roverics/tracked-platform/prototypes/p0/photos/README.md

# P0 Photos and Video

Add only curated evidence that supports a design or test record. Prefer descriptive filenames such as `2026-10-15_single-track-test_setup.jpg`, and link each file from its record with a caption explaining what it demonstrates.

Before committing, remove unnecessary EXIF location/device metadata and check frames for credentials, faces, addresses, customer material, and unrelated workshop information. Large media uses Git LFS; avoid raw dumps and duplicates.
