roverics/tracked-platform/prototypes/p0/electronics/firmware/README.md

# P0 Firmware

Store reproducible firmware and control sources here when available. Each project should document its target board, toolchain and version, locked dependencies, build and flash commands, configuration method, communications protocol, and safe default behavior.

Secrets and machine-specific configuration stay outside Git. Test records should cite the exact Git commit used.
