roverics/tracked-platform/prototypes/p0/electronics/docs/images/README.md

# Project Image Plan

No photographs are included yet. Add only photographs of the real hardware and keep captions factual. Useful filenames are:

| Filename | Suggested content |
|---|---|
| `01_initial_motor_test.jpg` | Uno, BTS7960, motor, and external supply used for the initial bench test |
| `02_nrf_bench_test.jpg` | Standard NRF24L01 radio-only bench setup |
| `03_controller_prototype.jpg` | Nano, joystick, and standard NRF24L01 controller prototype |
| `04_mega_bts7960_setup.jpg` | Mega receiver and BTS7960 rover-side setup |
| `05_encoder_setup.jpg` | Optical sensor and 20-slot encoder disk, including alignment |
| `06_tracked_chassis.jpg` | Current approximately 25 × 25 cm tracked chassis |
| `07_controller_mockup.jpg` | Temporary controller test bench or panel mock-up |
| `08_rover_electronics_mockup.jpg` | Temporary rover-side electronics test bench |

When adding an image, record the date, visible hardware, test context, and whether the setup produced a verified, partial, attempted, acquired-only, or planned result. Do not use concept renders as evidence of constructed hardware.
