roverics/tracked-platform/docs/r1-requirements.md

# R1 Requirements and Planning

Status: **planning only**. R1 is a future full-size, production-intent tracked platform. It has not been represented here as fabricated, tested, manufactured, or load-rated.

P0 results are inputs to R1 requirements; they are not automatically scalable proof. In particular, no validated 100 kg capacity is currently documented.

## Requirement method

Each requirement should eventually include an ID, measurable statement, rationale/source, verification method, owner, and status. Use `TBD` instead of guessing.

| ID | Topic | Requirement | Rationale/source | Verification | Status |
| --- | --- | --- | --- | --- | --- |
| R1-SYS-001 | Intended use | TBD after use cases and operating environment are agreed | Product planning | Review | Open |
| R1-MEC-001 | Payload/load definition | TBD; distinguish payload, gross mass, static load, and dynamic load cases | Safety and structure | Analysis plus instrumented test | Open |
| R1-MOB-001 | Mobility envelope | TBD surface, grade, obstacle, speed, and turning requirements | Use cases | Instrumented test | Open |
| R1-PWR-001 | Energy/runtime | TBD duty cycle, runtime, charging, and storage constraints | Use cases and safety | Analysis plus test | Open |
| R1-SAF-001 | Safe stop | TBD stopping, isolation, fault response, and emergency-stop behavior | Risk assessment | Inspection plus test | Open |
| R1-ENV-001 | Environment | TBD temperature, water/dust, corrosion, and storage ranges | Operating context | Analysis plus test | Open |
| R1-SVC-001 | Serviceability | TBD access, replaceable modules, tools, and maintenance intervals | Lifecycle planning | Demonstration | Open |

## Inputs needed before baselining

- prioritized customer/use cases;
- terrain and environmental definitions;
- payload versus vehicle mass terminology and targets;
- legal, transport, and safety constraints for intended markets;
- manufacturing volume and cost assumptions;
- P0 drivetrain, track, thermal, power, and control evidence; and
- subsystem interface definitions with measurable acceptance criteria.

A requirement is not “validated” until its stated verification is completed against an identified R1 configuration.
