roverics/tracked-platform/docs/evidence-media-review-2026-10-04.md

# Evidence media review — 4 October 2026

This date is the review date, not an inferred capture or fabrication date. Original files remain in their supplied folders.

| Source under `prototypes/p0/` | Evidence supported | Boundary |
| --- | --- | --- |
| `mechanical/exports/Artifact-01-Half-LAne-Chassis.jpg` | Physical partial lane assembly: printed structure, shafts, bearings, toothed wheels and belt drive visible | No powered operation, complete track circulation, calibrated dimensions or load result |
| `mechanical/exports/Boggie System.jpg` | CAD render of wheels, linkage and suspension layout | Does not establish fabricated suspension |
| `mechanical/exports/Roverics P0 Assembly.jpg` | Full-vehicle CAD arrangement | Does not establish assembled or driving whole vehicle |
| `electronics/export/Embedded.jpg` | Wired bench electronics, radio hardware, display module and illuminated indicators | No performance, safety or complete integration result |
| `electronics/export/LCD.jpg` | Screen visibly displays ROVER, 14.3V and a bar graphic | Value source and calibration unknown; do not equate this with validated live telemetry. Visible August 20 timestamp has no year |

Five mechanical STL exports are displayed through an on-demand Three.js viewer on the website: lane chassis, exposed drivetrain, bogie, middle chassis roof and RC shock absorber. Rotation, pan, zoom and wireframe are inspection aids. Source units and part revisions remain unspecified; the viewer normalizes geometry for display and provides no dimensional measurement claim.

The photos support partial physical assembly and visible display output beyond the earlier CAD/acquisition summaries. They do not supersede the historical single-motor and encoder test records, or establish powered-track operation. Requested follow-up: capture dates, part/configuration revisions, display firmware and signal source, and videos/raw data for powered tests.
