roverics/tracked-platform/(list of files, cad)

Other CAD files:
prototypes/p0/mechanical/exports/Lane Chassis Assembly.stl
prototypes/p0/mechanical/exports/Middle Chassis Roof Assembly.stl
prototypes/p0/mechanical/exports/Nked ane Chassis Assembly to Show Sp Rocket.stl
prototypes/p0/mechanical/exports/Roverics P0 Assembly.stl
prototypes/p0/mechanical/cad/Parts/gt2-40-teeth-bore-8mm-belt-6mm-1.snapshot.2/GT2_40T_8_6.STEP
prototypes/p0/mechanical/cad/Parts/gt2-timing-pulley-t40-1.snapshot.1/GT2 Timing Pulley T40.stp
prototypes/p0/mechanical/cad/Parts/timing-pulley-gt2-20t-8mm-bore-1.snapshot.8/GT2_20T-sh8.STEP
prototypes/p0/mechanical/cad/Sp Rocket Gear/Sp Rocket.dwg
prototypes/p0/mechanical/exports/Boggie System.stl
prototypes/p0/mechanical/exports/RC Shock Absorber.stl
prototypes/p0/mechanical/cad/Cabin/BTS7960 43A HIGH POWER H BRIDGE MODULE/BTS7960 43A HIGH POWER H BRIDGE MODULE.ipt
prototypes/p0/mechanical/cad/Cabin/Battery Pack.ipt
prototypes/p0/mechanical/cad/Cabin/Cabin 2nd Floor.ipt
prototypes/p0/mechanical/cad/Cabin/Cabin Assembly.iam
prototypes/p0/mechanical/cad/Cabin/Cabin Chassis Part 1.ipt
prototypes/p0/mechanical/cad/Cabin/Cabin Chassis Part 2.ipt
prototypes/p0/mechanical/cad/Cabin/CabinParameters.ipt
prototypes/p0/mechanical/cad/Cabin/Cover310-v2.ipt
prototypes/p0/mechanical/cad/Cabin/Motor/5840-31ZY D8.ipt
prototypes/p0/mechanical/cad/Full Assembly/Roverics P0 Assembly.iam
prototypes/p0/mechanical/cad/Lane Chassis/Boggie System/Boggie System.iam
prototypes/p0/mechanical/cad/Lane Chassis/Boggie System/Link_Gear_to_middle.ipt
prototypes/p0/mechanical/cad/Lane Chassis/Boggie System/Moddle Wheels Link.ipt
prototypes/p0/mechanical/cad/Lane Chassis/Custom RC Shock Absorber/Bigger Version/Rods.ipt
prototypes/p0/mechanical/cad/Lane Chassis/Custom RC Shock Absorber/Body.ipt
prototypes/p0/mechanical/cad/Lane Chassis/Custom RC Shock Absorber/Bot Cap.ipt
prototypes/p0/mechanical/cad/Lane Chassis/Custom RC Shock Absorber/RC Shock Absorber.iam
prototypes/p0/mechanical/cad/Lane Chassis/Custom RC Shock Absorber/Shaft.ipt
prototypes/p0/mechanical/cad/Lane Chassis/Custom RC Shock Absorber/Top Cap thread.ipt
prototypes/p0/mechanical/cad/Lane Chassis/Custom RC Shock Absorber/Top Cap-NO-THREAD.ipt
prototypes/p0/mechanical/cad/Lane Chassis/Custom RC Shock Absorber/Top Cap.ipt
prototypes/p0/mechanical/cad/Lane Chassis/Custom RC Shock Absorber/ring.ipt
prototypes/p0/mechanical/cad/Lane Chassis/EndWheelShaft.ipt
prototypes/p0/mechanical/cad/Lane Chassis/Idler Support.ipt
prototypes/p0/mechanical/cad/Lane Chassis/Lane Chassis Assembly.iam
prototypes/p0/mechanical/cad/Lane Chassis/Middle Chassis Assembly.iam
prototypes/p0/mechanical/cad/Lane Chassis/Middle Chassis Roof Assembly.iam
prototypes/p0/mechanical/cad/Lane Chassis/Middle Chassis-Left Cover - Begin.ipt
prototypes/p0/mechanical/cad/Lane Chassis/Middle Chassis-Left Cover - End.ipt
prototypes/p0/mechanical/cad/Lane Chassis/Middle Chassis-Right Cover - Begin.ipt
prototypes/p0/mechanical/cad/Lane Chassis/Middle Chassis-Right Cover - End.ipt
prototypes/p0/mechanical/cad/Lane Chassis/Middle Chassis-Roof.ipt
prototypes/p0/mechanical/cad/Lane Chassis/Roof Connector.ipt
prototypes/p0/mechanical/cad/Lane Chassis/TopWheelHolder.ipt
prototypes/p0/mechanical/cad/Lane Chassis/Wheels/Boggie-ParametricWheel.ipt
prototypes/p0/mechanical/cad/Lane Chassis/Wheels/DoubleWheel-part1.ipt
prototypes/p0/mechanical/cad/Lane Chassis/Wheels/DoubleWheel.iam
prototypes/p0/mechanical/cad/Lane Chassis/Wheels/End Wheel = Part 1.ipt
prototypes/p0/mechanical/cad/Lane Chassis/Wheels/End Wheel.iam
prototypes/p0/mechanical/cad/Lane Chassis/Wheels/EndWheelShaft.ipt
prototypes/p0/mechanical/cad/Lane Chassis/Wheels/MiddleWheelShaft.ipt
prototypes/p0/mechanical/cad/Lane Chassis/Wheels/ParametricWheel.ipt
prototypes/p0/mechanical/cad/Lane Chassis/Wheels/TopRoller-Begin-ParametricWheel.ipt
prototypes/p0/mechanical/cad/Lane Chassis/Wheels/TopRoller-End-ParametricWheel.ipt
prototypes/p0/mechanical/cad/Lane Chassis/Wheels/TopRoller-Mid-ParametricWheel.ipt
prototypes/p0/mechanical/cad/Lane Chassis/Wheels/TopRoller-Middle ParametricWheel.ipt
prototypes/p0/mechanical/cad/Lane Chassis/Wheels/TopRollerAssmbly-Begin.iam
prototypes/p0/mechanical/cad/Lane Chassis/Wheels/TopRollerAssmbly-End.iam
prototypes/p0/mechanical/cad/Lane Chassis/Wheels/TopRollerAssmbly-Middle.iam
prototypes/p0/mechanical/cad/Lane Chassis/Wheels/TopRollerShaft-Begin.ipt
prototypes/p0/mechanical/cad/Lane Chassis/Wheels/WHHEL LINK CONNECTOR.ipt
prototypes/p0/mechanical/cad/Lane Chassis/Wheels/Wheel 20.ipt
prototypes/p0/mechanical/cad/Lane Chassis/Wheels/Wheel 25.ipt
prototypes/p0/mechanical/cad/Lane Chassis/Wheels/Wheel 30.ipt
prototypes/p0/mechanical/cad/Lane Chassis/Wheels/Wheel 30_MIR.ipt
prototypes/p0/mechanical/cad/Lane Chassis/Wheels/Wheel 40.ipt
prototypes/p0/mechanical/cad/Lane Chassis/Wheels/Wheel Link Column.ipt
prototypes/p0/mechanical/cad/Lane Chassis/Wheels/Wheels Link.ipt
prototypes/p0/mechanical/cad/Lane Chassis/Wheels/Whhel 20 Assembly.iam
prototypes/p0/mechanical/cad/Lane Chassis/Wheels/Whhel 30 Assembly.iam
prototypes/p0/mechanical/cad/Lane Chassis/Wheels/Whhel 30 Assembly_MIR5.iam
prototypes/p0/mechanical/cad/Lane Chassis/Wheels/Whhel 40 Assembly.iam
prototypes/p0/mechanical/cad/MasterParameters.ipt
prototypes/p0/mechanical/cad/Motor Shaft/Faield Tests/RollerChainSprocket_8T_6.35mm-Sprocket/RollerChainSprocket_8T_6.35mm-Sprocket/RollerChainSprocket_8T_6.35mm-Sprocket.ipt
prototypes/p0/mechanical/cad/Motor Shaft/Faield Tests/Shaft for Chain System/Assembly1.iam
prototypes/p0/mechanical/cad/Motor Shaft/Faield Tests/Shaft for Chain System/Gear.ipt
prototypes/p0/mechanical/cad/Motor Shaft/Faield Tests/Shaft for Chain System/Motor Shaft Assembly.iam
prototypes/p0/mechanical/cad/Motor Shaft/Faield Tests/Shaft for Chain System/Motor Shaft.ipt
prototypes/p0/mechanical/cad/Motor Shaft/Faield Tests/Shaft for Chain System/Part7.ipt
prototypes/p0/mechanical/cad/Motor Shaft/Faield Tests/Shaft for Chain System/Shaft Chain.ipt
prototypes/p0/mechanical/cad/Motor Shaft/Faield Tests/Shaft for Chain System/Shaft Mold.ipt
prototypes/p0/mechanical/cad/Motor Shaft/Faield Tests/Shaft for Chain System/Small Gear.ipt
prototypes/p0/mechanical/cad/Motor Shaft/Faield Tests/Shaft for Chain System/large gear.ipt
prototypes/p0/mechanical/cad/Motor Shaft/Faield Tests/gear test.ipt
prototypes/p0/mechanical/cad/Motor Shaft/Faield Tests/test/16teeth gear/16teeth gear/16teeth gear.ipt
prototypes/p0/mechanical/cad/Motor Shaft/Faield Tests/test/shaft-test.ipt
prototypes/p0/mechanical/cad/Motor Shaft/Faield Tests/test/test shaft assmebly.iam
prototypes/p0/mechanical/cad/Motor Shaft/Shaft Part1.ipt
prototypes/p0/mechanical/cad/Motor Shaft/Shaft Part2.ipt
prototypes/p0/mechanical/cad/Motor Shaft/Shaft.ipt
prototypes/p0/mechanical/cad/Optocounter/Disk.ipt
prototypes/p0/mechanical/cad/Parts/2.3X12mm rod.ipt
prototypes/p0/mechanical/cad/Parts/2mm rod.ipt
prototypes/p0/mechanical/cad/Parts/Coupling-25X8.ipt
prototypes/p0/mechanical/cad/Parts/bearing.ipt
prototypes/p0/mechanical/cad/Parts/gt2-40-teeth-bore-8mm-belt-6mm-1.snapshot.2/GT2_40T_8_6.IGS
prototypes/p0/mechanical/cad/Parts/gt2-40-teeth-bore-8mm-belt-6mm-1.snapshot.2/GT2_40T_8_6.SLDPRT
prototypes/p0/mechanical/cad/Parts/gt2-40-teeth-bore-8mm-belt-6mm-1.snapshot.2/GT2_40T_8_6/GT2_40T_8_6/GT2_40T_8_6.ipt
prototypes/p0/mechanical/cad/Parts/gt2-timing-pulley-t40-1.snapshot.1/GT2 Timing Pulley T40.ipt
prototypes/p0/mechanical/cad/Parts/rOD-65x3.5.ipt
prototypes/p0/mechanical/cad/Parts/small rod.ipt
prototypes/p0/mechanical/cad/Parts/timing-pulley-gt2-20t-8mm-bore-1.snapshot.8/GT2_20T-sh8.IGS
prototypes/p0/mechanical/cad/Parts/timing-pulley-gt2-20t-8mm-bore-1.snapshot.8/GT2_20T-sh8.SLDDRW
prototypes/p0/mechanical/cad/Parts/timing-pulley-gt2-20t-8mm-bore-1.snapshot.8/GT2_20T-sh8.SLDPRT
prototypes/p0/mechanical/cad/Parts/timing-pulley-gt2-20t-8mm-bore-1.snapshot.8/GT2_20T-sh8/GT2_20T-sh8/GT2_20T-sh8.ipt
prototypes/p0/mechanical/cad/Sp Rocket Gear/Assembly1.iam
prototypes/p0/mechanical/cad/Sp Rocket Gear/Gear Assenbly.iam
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
