roverics/tracked-platform/(commit log)

2026-09-30 firmware folder meved to electronicsand motor test added
2026-09-30 init mechanics
    [16teeth gear.ipt, 2.3X12mm rod.ipt, 2mm rod.ipt, 5840-31ZY D8.ipt, Assembly1.iam, BTS7960 43A HIGH POWER H BRIDGE MODULE.ipt, Battery Pack.ipt, Body.ipt]
2026-10-03 prepare exports for website
    [Body.ipt, Boggie System.stl, Bot Cap.ipt, End Wheel = Part 1.ipt, EndWheelShaft.ipt, GT2_40T_8_6.ipt, Lane Chassis Assembly.iam, Lane Chassis Assembly.stl]
